2026dts/Oil_Rig/overall_circuit.jpeg

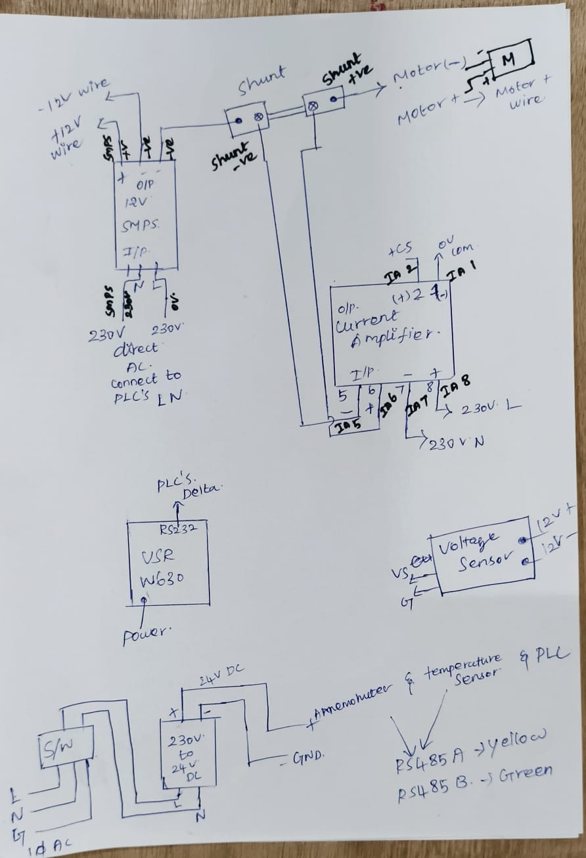
overall_circuit.jpeg
