2026dts/Oil_Rig/Plc diagram.jpeg

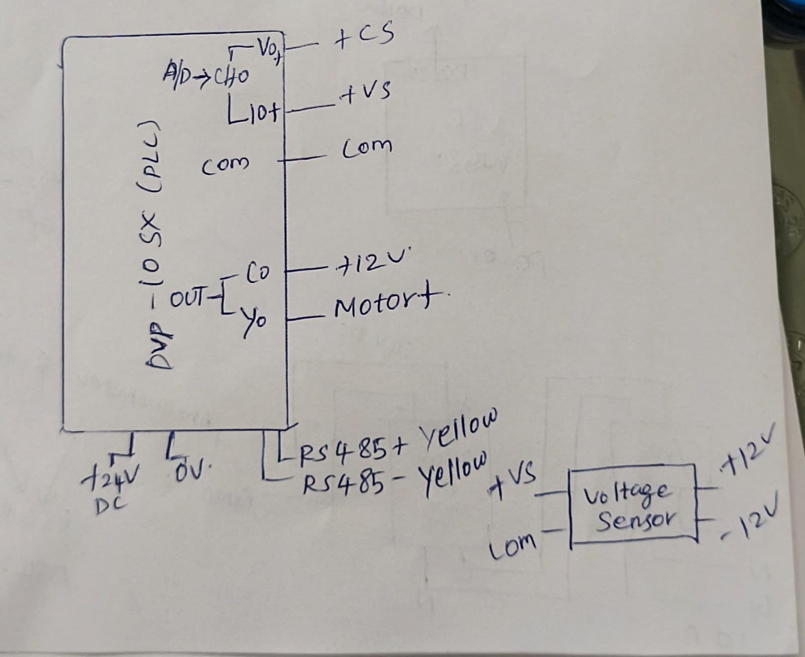
Plc diagram.jpeg
