2026dts/Oil_Rig/reference Diagram.png

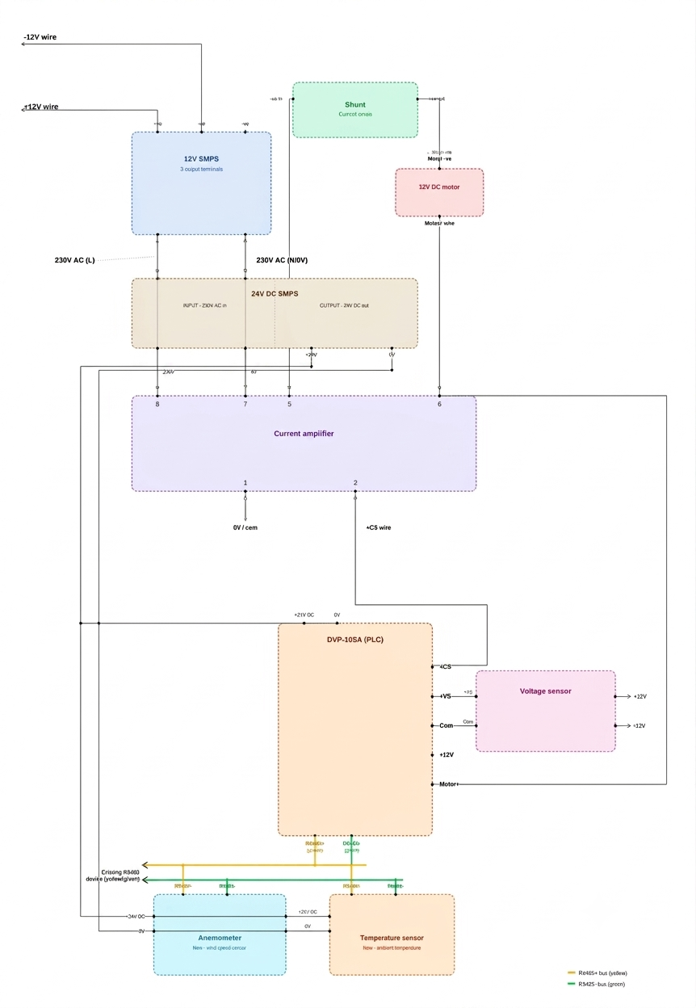
reference Diagram.png
