2026dts/Oil_Rig/Circuit_Diagram_of_PLC.pdf

# +24V / 0V / 1.5 +12V / 2.0

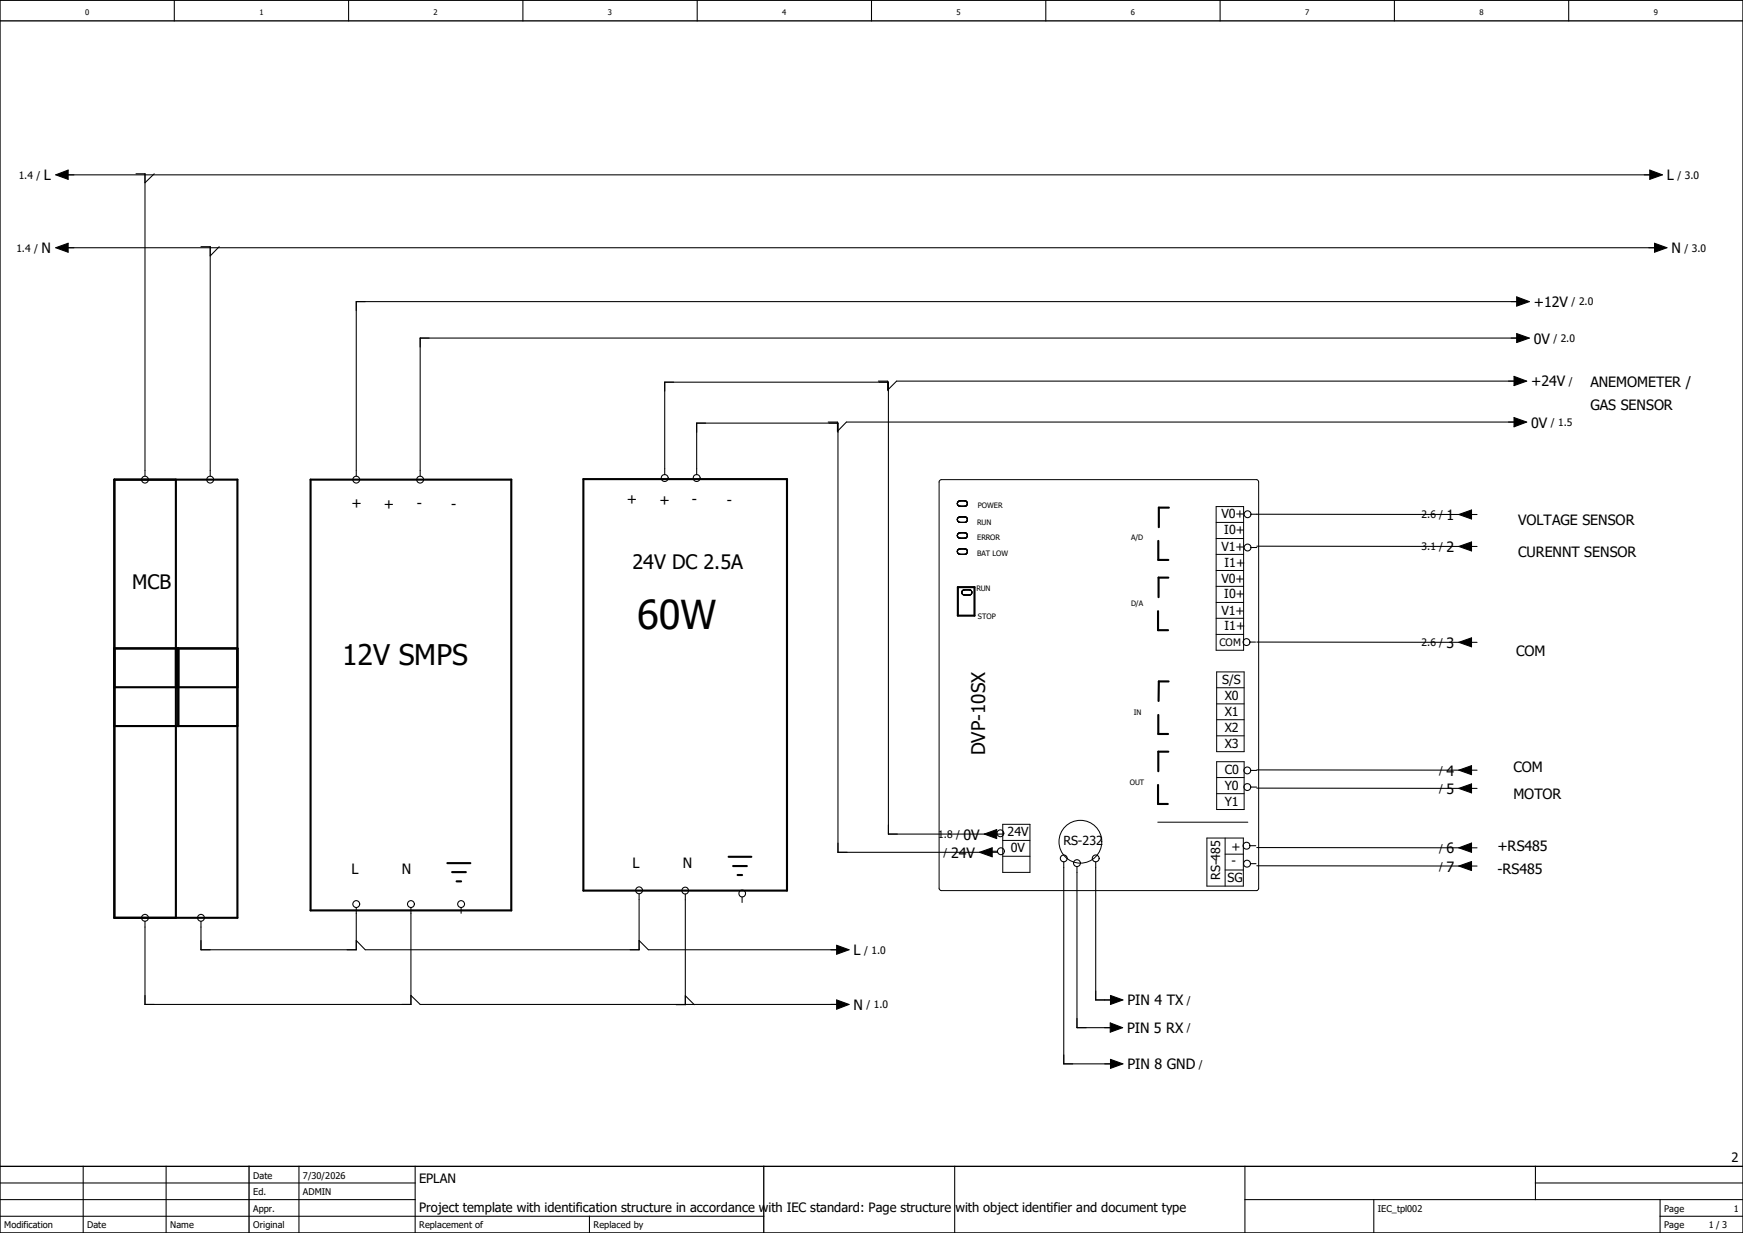
[picture p4: page 1]
Page Page Project template with identification structure in accordance with IEC standard: Page structure with object identifier and document type Ed. Original; IEC_tpl002 EPLAN; Appr.; Replacement of; 1 / 3 DVP⁻10SX; I1+ V0+ I0+ V1+ I1+ COM; POWER; RUN; ERROR; BAT LOW; STOP; IN OUT; VOLTAGE SENSOR; CURENNT SENSOR; COM; MOTOR; ANEMOMETER / GAS SENSOR; 12V SMPS ⁺ +; MCB

PIN 4 TX / PIN 5 RX / PIN 8 GND / L / 1.0 N / 1.0

7/30/2026 | Replaced by

Date | ADMIN Date

Modification | Name

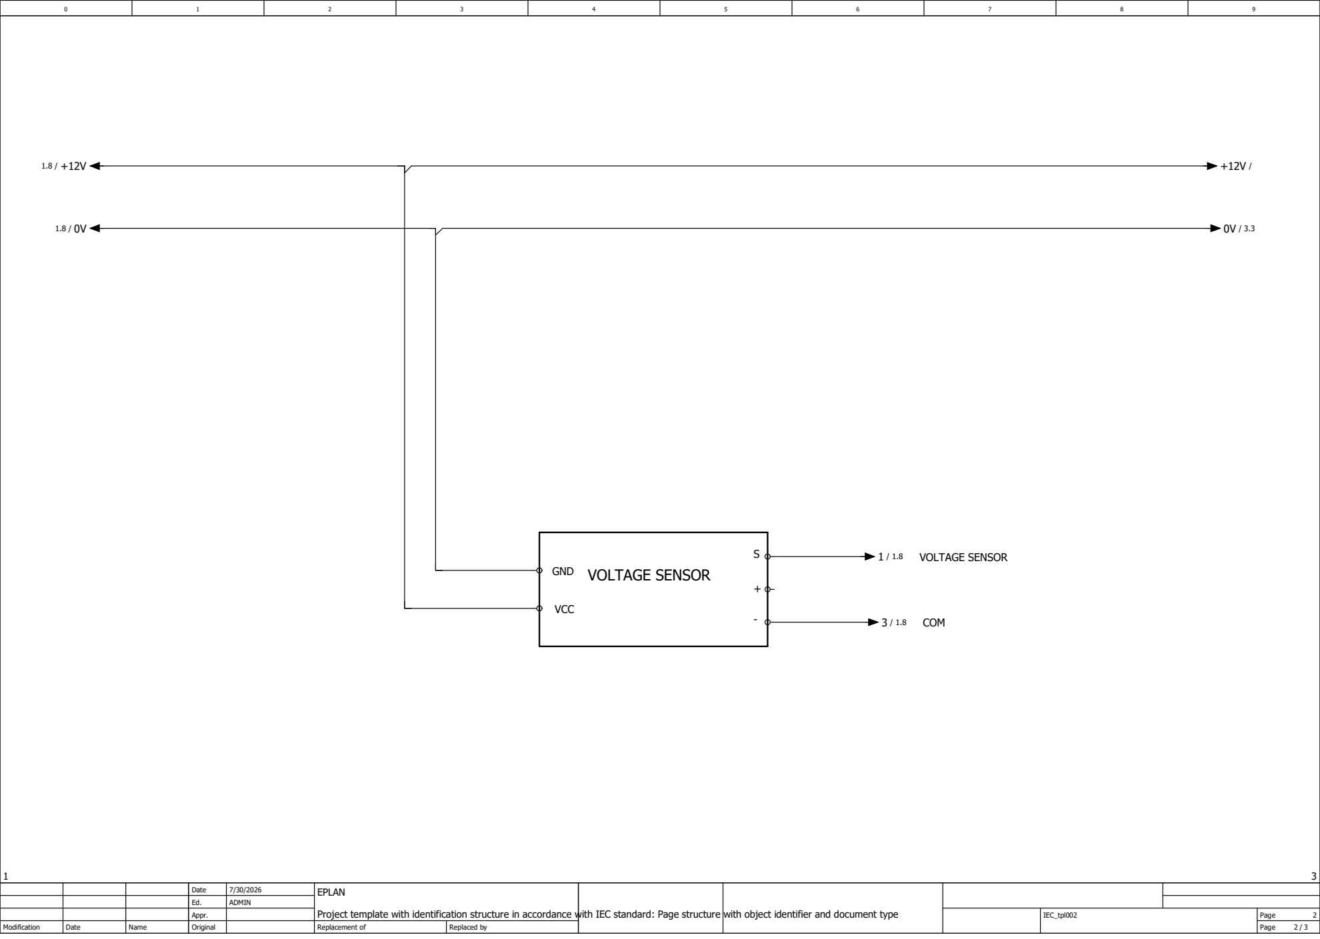
[picture p5: figure]
Replaced by; Date; ADMIN Date; Modification; Name; Appr.; Replacement of; VOLTAGE SENSOR; COM; S+ - GND; VCC

Page Page Project template with identification structure in accordance with IEC standard: Page structure with object identifier and document type Ed. 1 | Original | IEC_tpl002 EPLAN

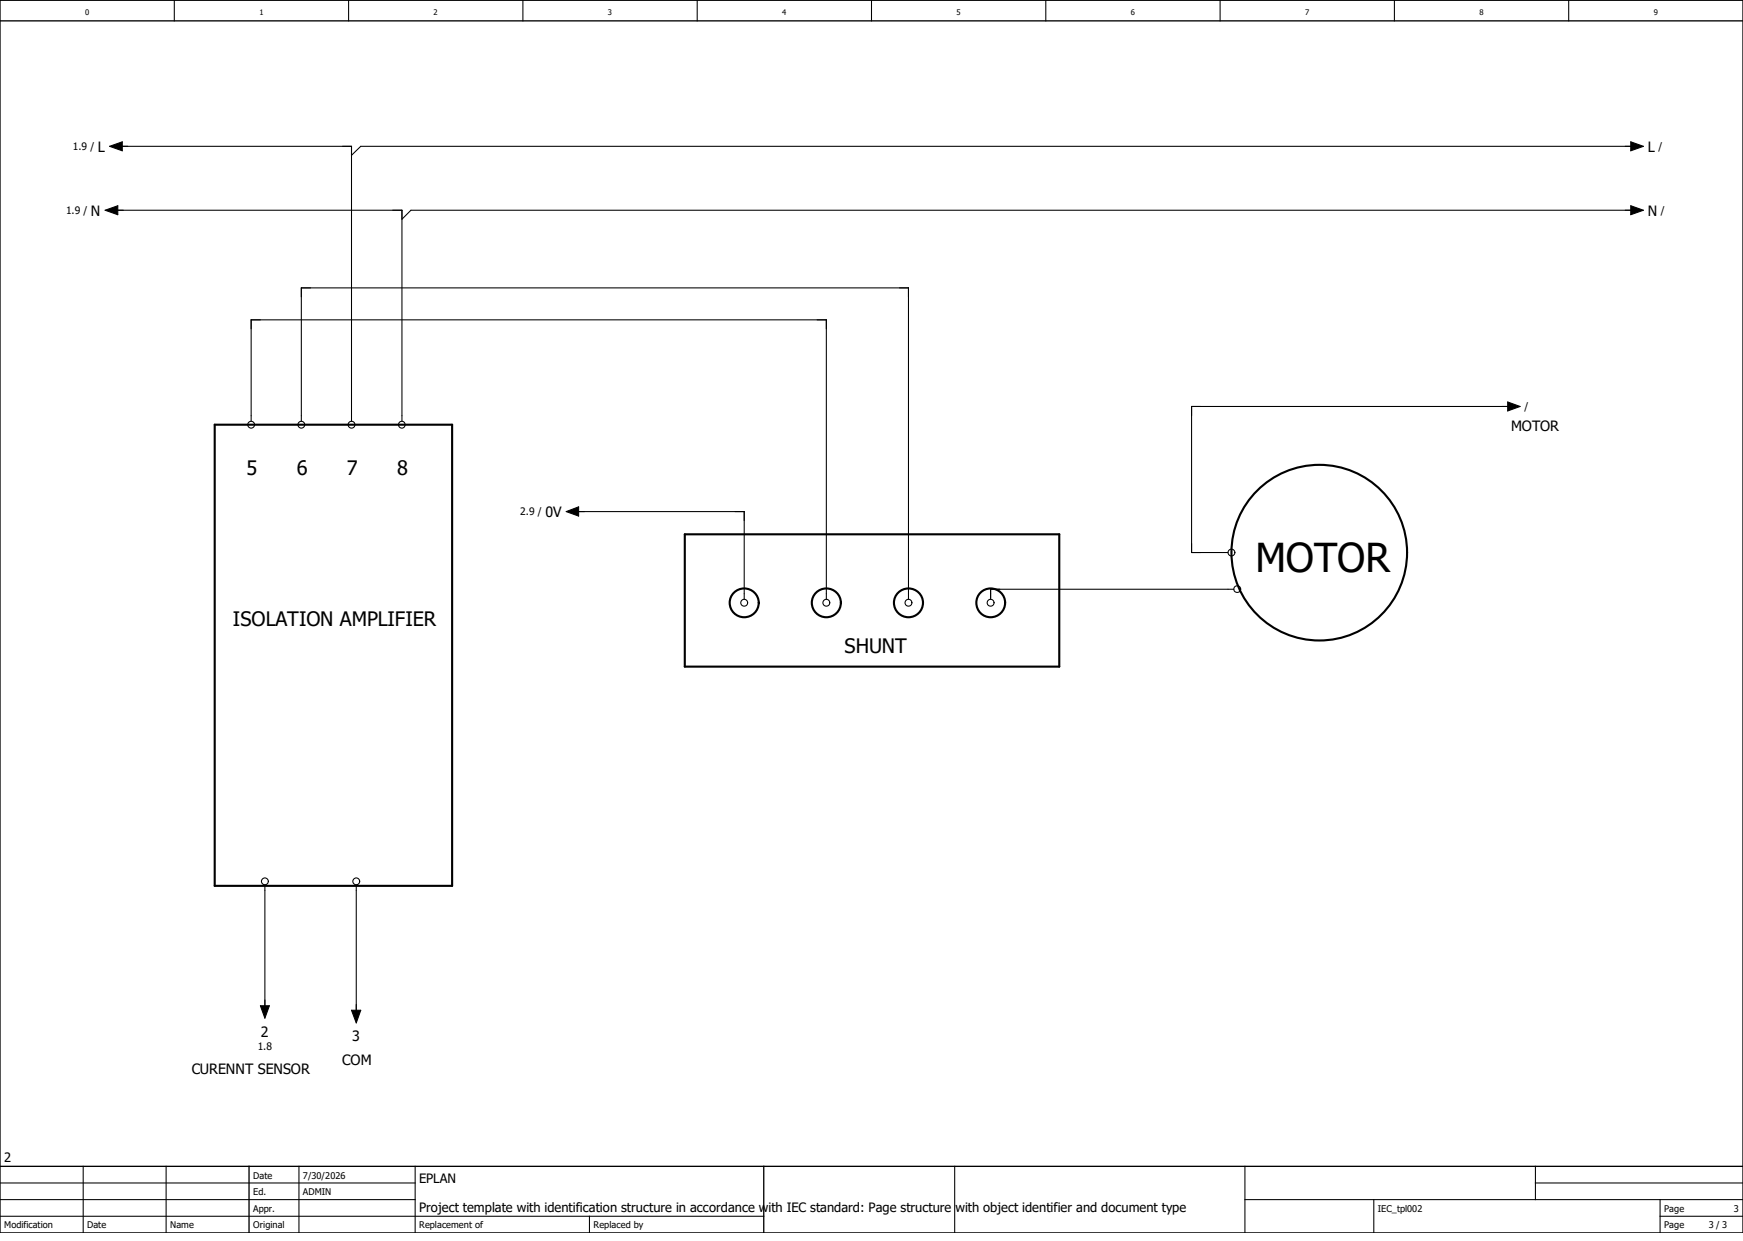
[picture p6: page 3]
Page Page Project template with identification structure in accordance with IEC standard: Page structure with object identifier and document type Ed. 2; Original; IEC_tpl002 EPLAN; Appr.; Replacement of; MOTOR; ISOLATION AMPLIFIER; SHUNT

COM CURENNT SENSOR

7/30/2026 | Replaced by

Date | ADMIN Date

Modification | Name | 3 / 3
