2026dts/Oil_Rig/(commit log)

2026-07-29 added circuit diagrams
2026-07-31 added timing calculation,flow meter and circut diagram
    [motor_runtime_state.json, wind_speed_diagnostic_log.csv]
2026-08-20 added the readme ,implementation documents
    [motor_runtime_state.json]
2026-09-02 added the esp Relay code
